CristianoUTEC/Flordelana/README.md

# Flordelana
Repositorio destinado a compartir el diseño de ruecas motorizadas para el hilado artesanal de lana.
