CristianoUTEC/Flordelana/Planos/dibujo.pdf

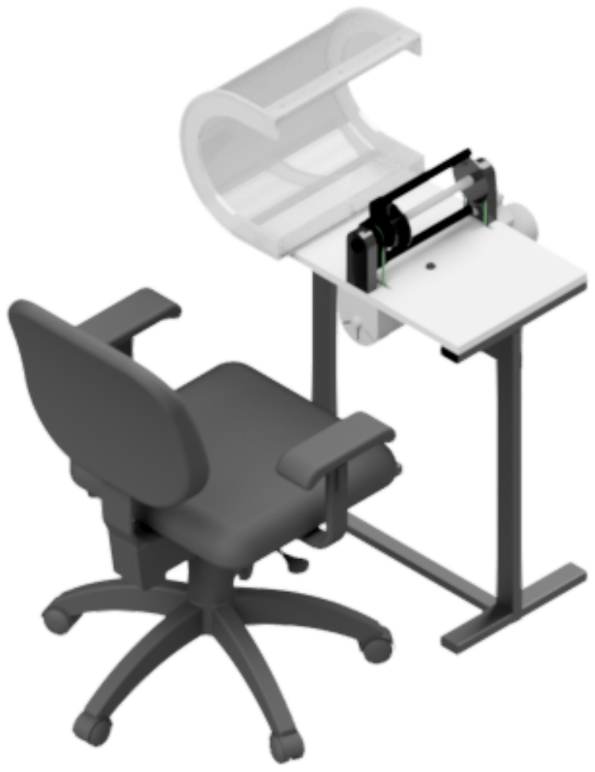
[picture p1: page 1]
