CristianoUTEC/Flordelana/CAD/Montaje.stp

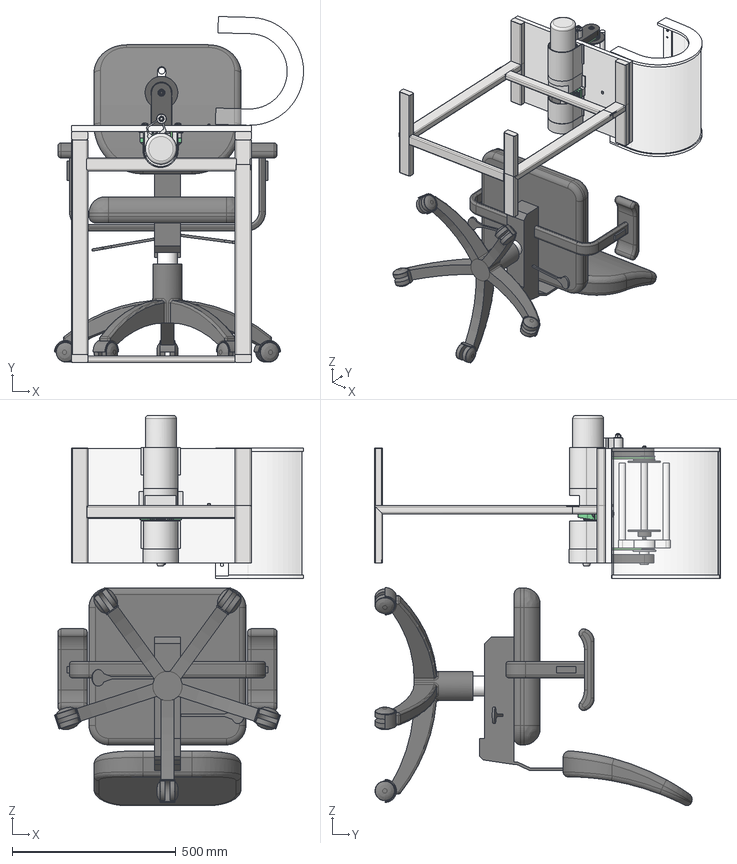
[picture p2: CAD file, 2021-09-22]
CAD/Montaje.stp
761.7 x 1057.9 x 1193.4 mm
soporte_riel
ANSI/AFBMA 16.1 - 25 x 47 x 14
soporte_riel_1
DIN 471 - 10x1 x 2
Centro
Reel1ACABARMEDIDAS
Reel1ACABARMEDIDAS_1
SKF_6000_PART1 x 2
SKF_6000_PART2 x 2
SKF_6000_PART3 x 14
SKF_6000_PART4 x 14
Sup.Acrilico x 4
Acrilico
Base.pin.Seg
Tapa Frontar y Posterior x 2
extructura_mesa
Skeleton 1572033469408
ISO 12633-2 - 50x25x2.5 - 350
ISO 12633-2 - 50x25x2.5 - 175
ISO 12633-2 - 50x25x2.5 - 175_1
ISO 12633-2 - 50x25x2.5 - 175_2
ISO 12633-2 - 50x25x2.5 - 175_3
ISO 12633-2 - 50x25x2.5 - 175_4
ISO 12633-2 - 50x25x2.5 - 175_5
ISO 12633-2 - 50x25x2.5 - 681
ISO 12633-2 - 50x25x2.5 - 606
ISO 12633-2 - 50x25x2.5 - 75
ISO 4019 - 40x20x2 - 550
ISO 4019 - 40x20x2 - 452,5
Placa Esquinas empalmadas (mm) 25 x 50 x 1 x 8
mesa_1
TapaEje_1
TapaEje_3 x 2
TapaEje_2
Cadeira_preta
ISO 4032 - M8 x 4
ISO 4014 - M8 x 55 x 4
ANSI/AFBMA 16.1 - 10 x 22 x 6
ISO 4014 - M10 x 70
ISO 7089 - 14
ISO 4032 - M10
PB-2P-MPBS
soporte planetario
brazos_planetarios1 x 2
brazos_planetarios1_1 x 2
vailla enroscada
UCP-204
Eje_Base
SoporteMancal
PoleaBrazos
motor2
PoleaBrazos_1
ISO 7045 - M10 x 60 - 4.8 - Z x 2
ISO 4035 - M10 x 2
Polea x 2
