CristianoUTEC/Flordelana/(list of files, cad)

Other CAD files:
CAD/TapaSeguridad/TapaSeguridad-1.dwg
CAD/TapaSeguridad/OldVersions/TapaSeguridad-1.0002.dwg
CAD/10 mm to 10mm flexible shaft coupler.ipt
CAD/608RS.ipt
CAD/ANSI_AFBMA 16.1 - 10 x 22 x 6.ipt
CAD/ANSI_AFBMA 16.1 - 25 x 37 x 7.ipt
CAD/Cadeira_preta.ipt
CAD/Conjunto transimisión.iam
CAD/DIN 471 - 10x1.ipt
CAD/DIN 471 - 22x1,2.ipt
CAD/Eje_Base.ipt
CAD/ISO 2491 - A 5 x 3 x 10.ipt
CAD/ISO 4161 - M10.ipt
CAD/KP08.iam
CAD/KP08.ipt
CAD/Mesa.iam
CAD/Mesa.ipt
CAD/Mesa/Frame/Frame 1572033469407.iam
CAD/Mesa/Frame/ISO 40x20x2 1572033628535.ipt
CAD/Mesa/Frame/ISO 40x20x2 1572033700429.ipt
CAD/Mesa/Frame/ISO 50x25x2.5 1572033477965.ipt
CAD/Mesa/Frame/ISO 50x25x2.5 1572033477966.ipt
CAD/Mesa/Frame/ISO 50x25x2.5 1572033477967.ipt
CAD/Mesa/Frame/ISO 50x25x2.5 1572033538820.ipt
CAD/Mesa/Frame/ISO 50x25x2.5 1572033538821.ipt
CAD/Mesa/Frame/ISO 50x25x2.5 1572033538822.ipt
CAD/Mesa/Frame/ISO 50x25x2.5 1572033538823.ipt
CAD/Mesa/Frame/ISO 50x25x2.5 1572033538824.ipt
CAD/Mesa/Frame/ISO 50x25x2.5 1572033538825.ipt
CAD/Mesa/Frame/ISO 50x25x2.5 1572033538826.ipt
CAD/Mesa/Frame/Plate Esquinas empalmadas (mm) 1572034518632.ipt
CAD/Mesa/Frame/Skeleton 1572033469408.ipt
CAD/Montaje Bobinador.iam
CAD/Montaje Bobinador.ipn
CAD/Montaje Reel.iam
CAD/Montaje.iam
CAD/Montaje.ipn
CAD/MontajeCon Cadeira.ipt
CAD/PK000.ipt
CAD/Polea.ipt
CAD/PoleaBrazos.ipt
CAD/PoleaMotor.ipt
CAD/Reel1.ipt
CAD/Reel2.ipt
CAD/SoporteMancal.ipt
CAD/Switch.ipt
CAD/TapaEje.iam
CAD/TapaEje1.ipt
CAD/TapaEje2.ipt
CAD/TapaEje3.ipt
CAD/TapaSeguridad/Acrilico.ipt
CAD/TapaSeguridad/Base.pin.Seg.ipt
CAD/TapaSeguridad/OldVersions/Acrilico.0013.ipt
CAD/TapaSeguridad/OldVersions/Base.pin.Seg.0004.ipt
CAD/TapaSeguridad/OldVersions/Sup.Acrilico.0009.ipt
CAD/TapaSeguridad/OldVersions/Tapa Frontar y Posterior.0002.ipt
CAD/TapaSeguridad/OldVersions/TapaSeguridad.0028.iam
CAD/TapaSeguridad/Sup.Acrilico.Segur.ipt
CAD/TapaSeguridad/Sup.Acrilico.ipt
CAD/TapaSeguridad/Tapa Frontar y Posterior.ipt
CAD/TapaSeguridad/TapaSeguridad.iam
CAD/UCP-204.ipt
CAD/Varilla_Enroscada.ipt
CAD/brazos_planetarios1.ipt
CAD/brazos_planetarios1v2.ipt
CAD/brazos_planetarios2.ipt
CAD/extructura_mesa.ipt
CAD/motor.ipt
CAD/soporte planetario.ipt
CAD/soporte_riel.ipt
CAD/soporte_riel2.ipt
CAD/soporte_rueca.ipt
