CristianoUTEC/Flordelana/Planos/Montaje.png

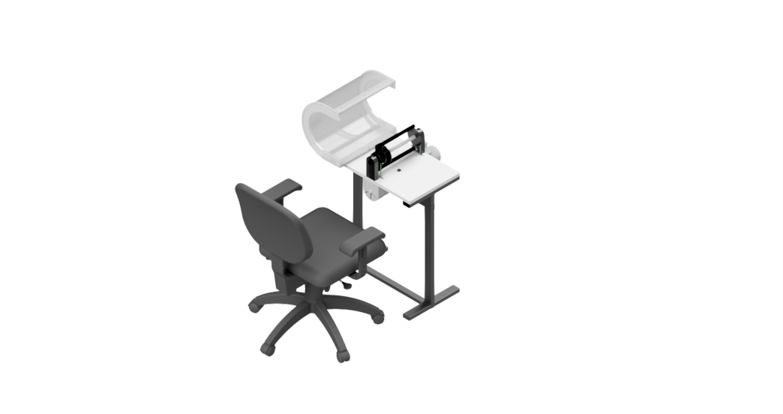
Planos/Montaje.png
