CristianoUTEC/Flordelana/Planos/Intructivo de Montaje.pdf

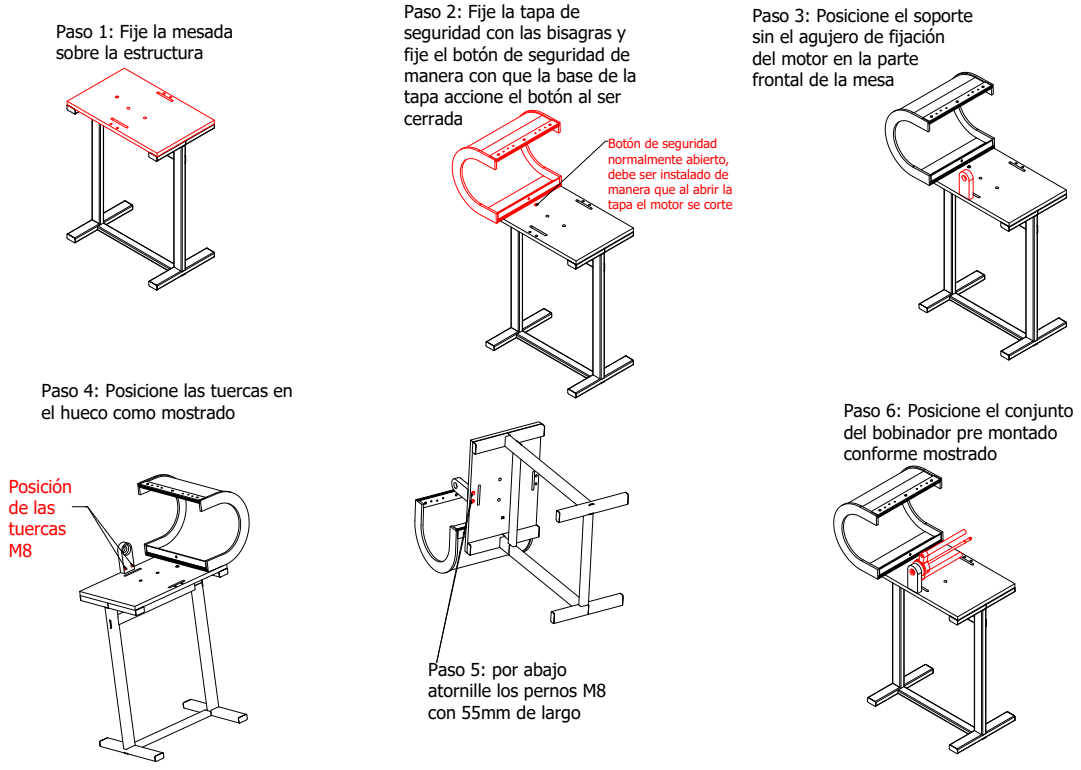
[picture p4: page 1]
de las

Paso 2: Fije la tapa de
seguridad con las bisagras y
fije el botyn de seguridad de
manera con que la base de la
tapa accione el botyn al ser
cerrada

Paso 3: Posicione el soporte
sin el agujero de fijaciyn
del motor en la parte
frontal de la mesa

Paso 1: Fije la mesada
sobre la estructura

Botyn de seguridad
normalmente abierto,
debe ser instalado de
manera que al abrir la
tapa el motor se corte

Paso 4: Posicione las tuercas en
el hueco como mostrado

Paso 6: Posicione el conjunto
del bobinador pre montado
conforme mostrado

Paso 5: por abajo
atornille los pernos M8
con 55mm de largo

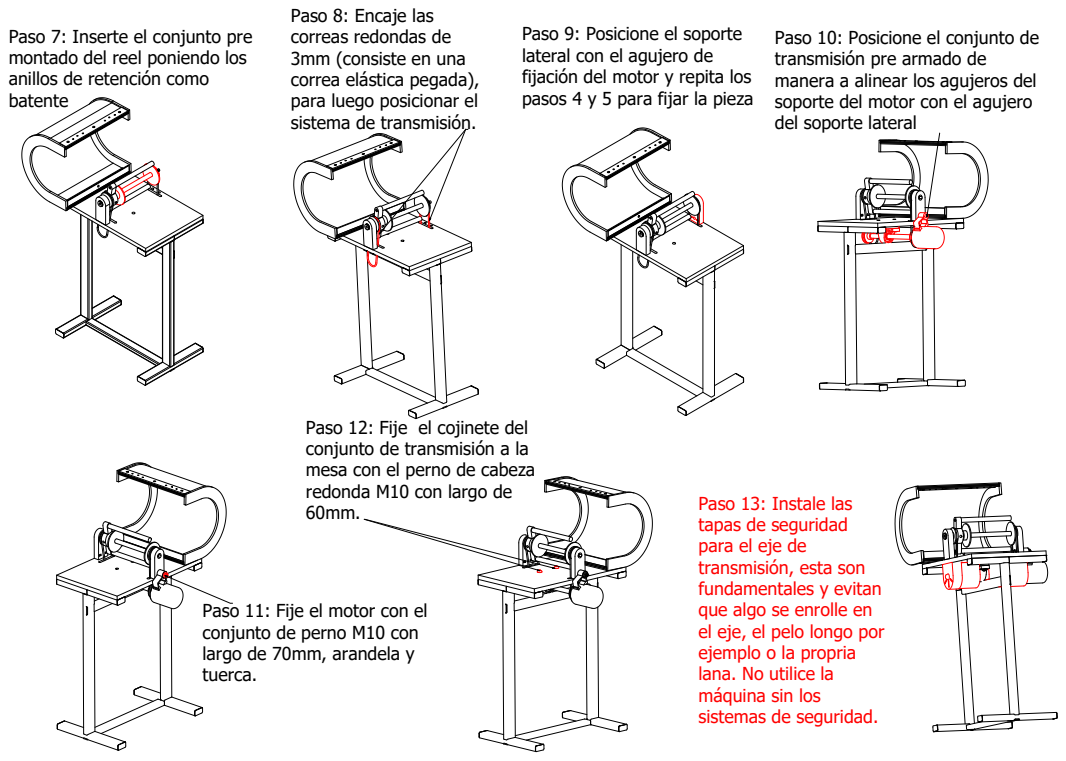
[picture p5: page 2]

Paso 8: Encaje las
correas redondas de
3mm (consiste en una
correa elistica pegada),
para luego posicionar el
sistema de transmisiyn.

Paso 9: Posicione el soporte
lateral con el agujero de
fijaciyn del motor y repita los
pasos 4 y 5 para fijar la pieza

Paso 7: Inserte el conjunto pre
montado del reel poniendo los
anillos de retenciyn como
batente

Paso 10: Posicione el conjunto de
transmisiyn pre armado de
manera a alinear los agujeros del
soporte del motor con el agujero
del soporte lateral

Paso 12: Fije el cojinete del
conjunto de transmisiyn a la
mesa con el perno de cabeza
redonda M10 con largo de

Paso 13: Instale las
tapas de seguridad
para el eje de
transmisiyn, esta son
fundamentales y evitan
que algo se enrolle en
el eje, el pelo longo por
ejemplo o la propria
lana. No utilice la
miquina sin los
sistemas de seguridad.

Paso 11: Fije el motor con el
conjunto de perno M10 con
largo de 70mm, arandela y
tuerca.
