CristianoUTEC/Flordelana/Planos/Mesa.pdf

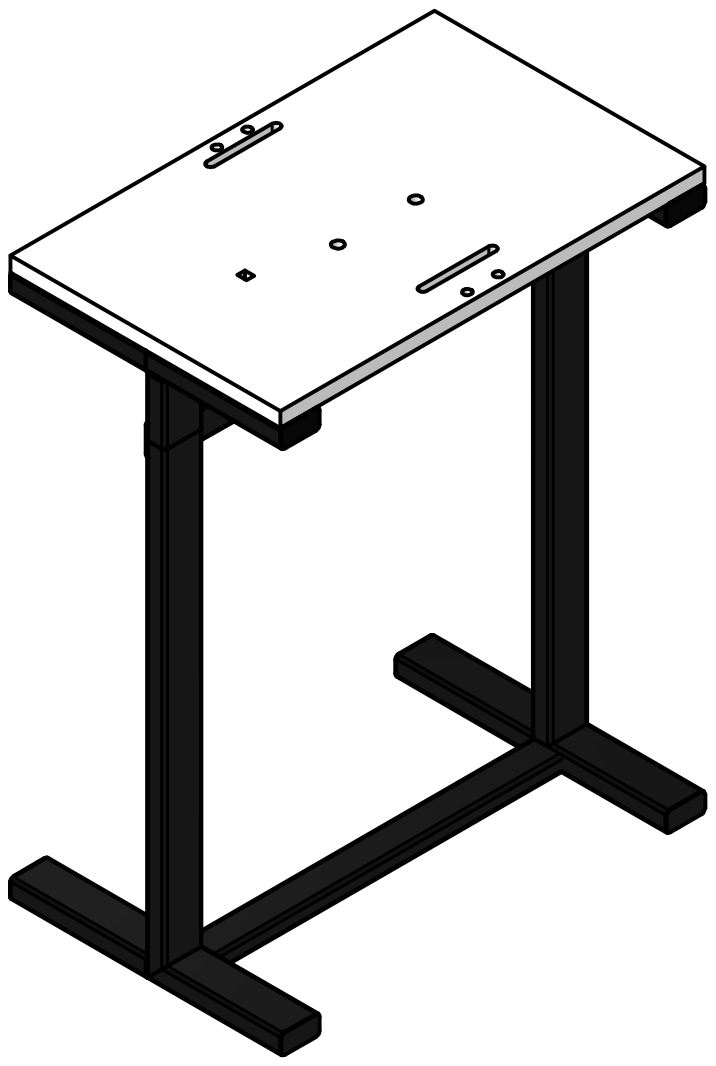
[picture p6: page 1]

Num. | Nombre: | Qtd. | Coment.

Nombre del archivo: Mesa.idw | Fecha: 17/8/2021

Escala:

Curso: Tecnylogo en Mec. Ind. | 1 Hoja:

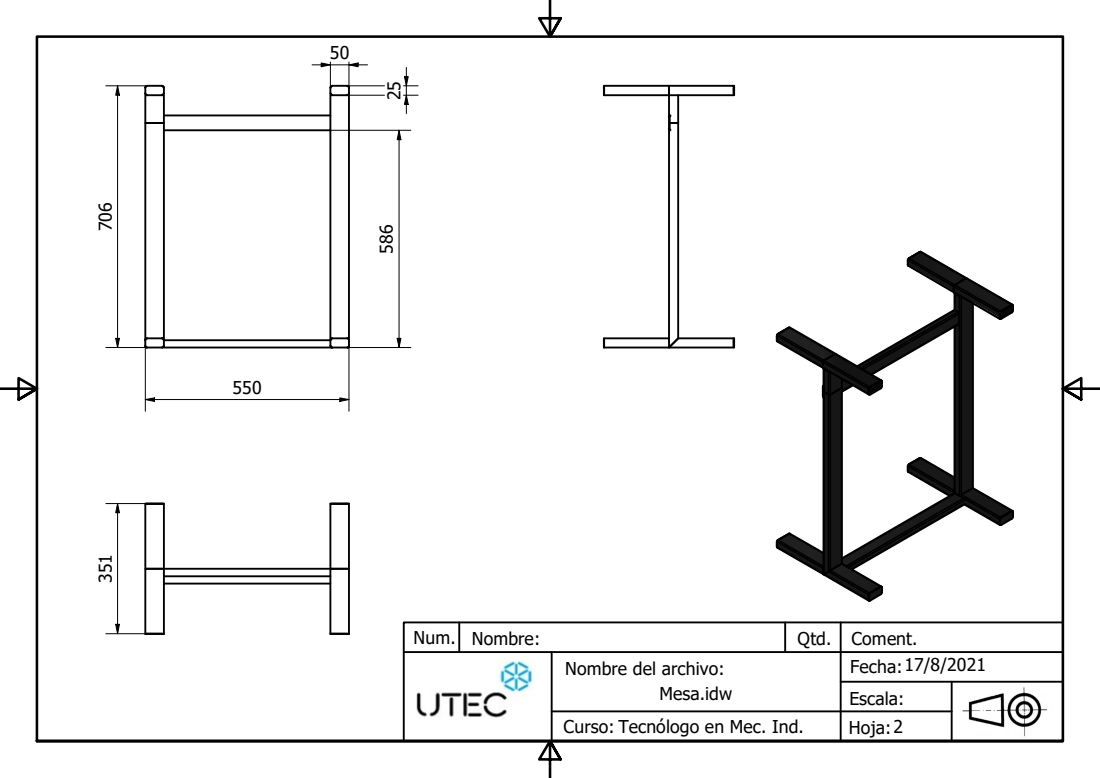
[picture p7: page 2]

Num. | Nombre: | Qtd. | Coment.

Nombre del archivo: Mesa.idw | Fecha: 17/8/2021

Escala:

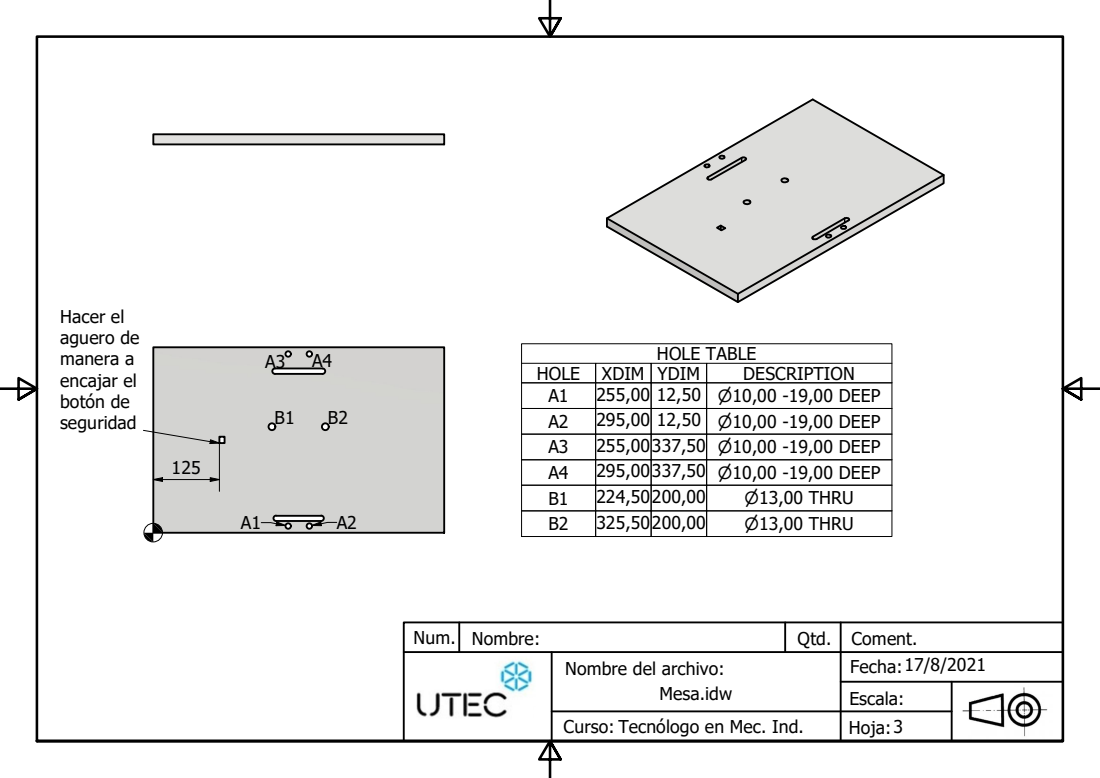
[picture p8: page 3]
HOLE TABLE; Hacer el aguero de manera a encajar el botyn de

HOLE | XDIM | YDIM | DESCRIPTION
A1 | 255,00 | 12,50 | 10,00 -19,00 DEEP
A2 | 295,00 | 12,50 | 10,00 -19,00 DEEP
A3 | 255,00337,50 | | 10,00 -19,00 DEEP
A4 | 295,00337,50 | | 10,00 -19,00 DEEP
B1 | 224,50200,00 | | 13,00 THRU
B2 | 325,50200,00 | | 13,00 THRU

Num. | Nombre: | Qtd. | Coment.

Nombre del archivo: Mesa.idw | Fecha: 17/8/2021

Escala:
