CristianoUTEC/Flordelana/Planos/Montaje Bobinador.pdf

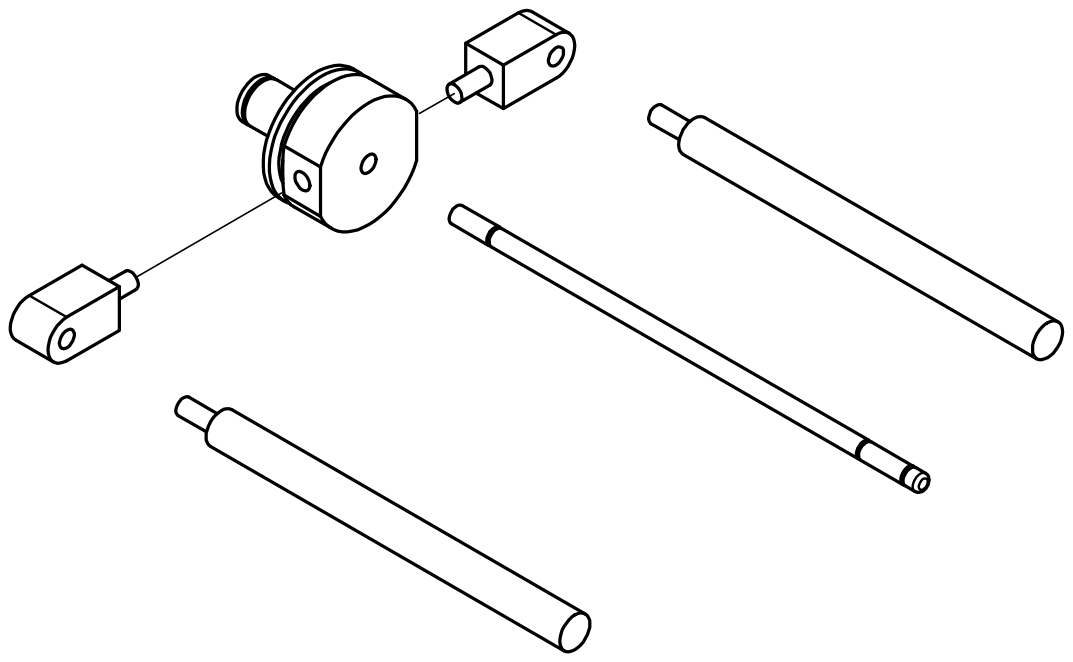
[picture p9: page 1]

Num. | Nombre: | Qtd. | Coment.

Nombre del archivo: Montaje Bobinador.idw | Fecha: 17/8/2021

Escala:

Curso: Tecnylogo en Mec. Ind. | 1 Hoja:

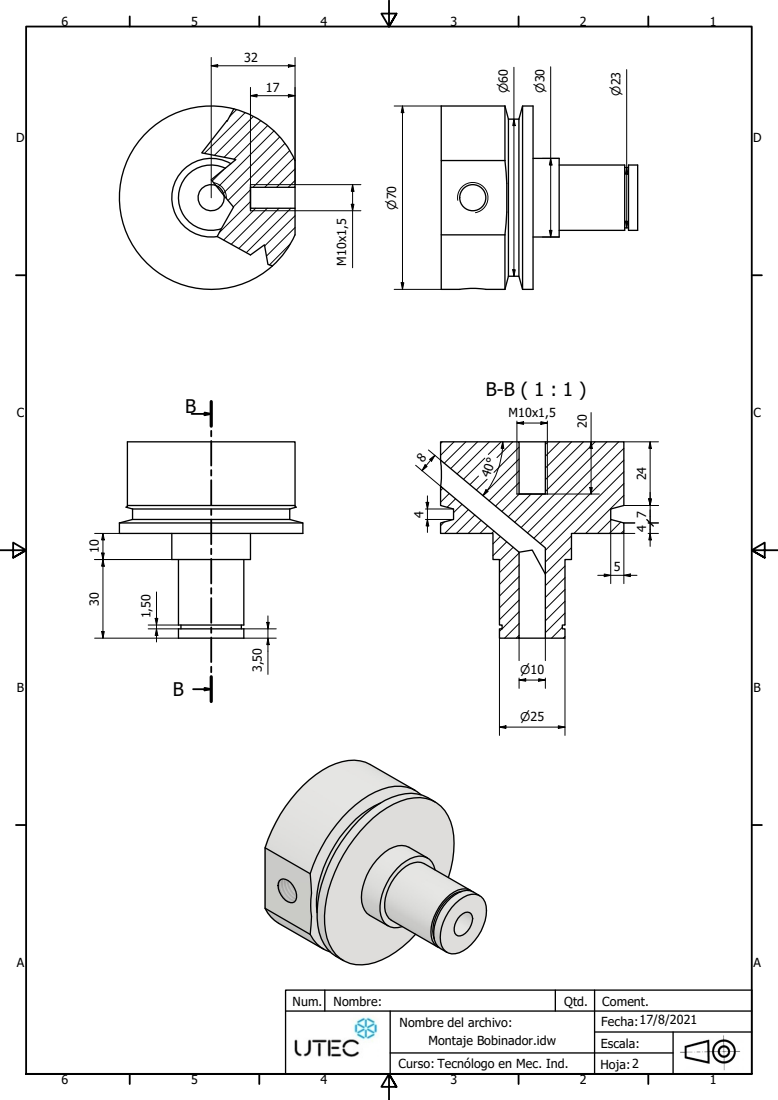
[picture p10: page 2]

Num. | Nombre: | Qtd. | Coment.

Nombre del archivo: Montaje Bobinador.idw | 17/8/2021 Fecha:

Escala:

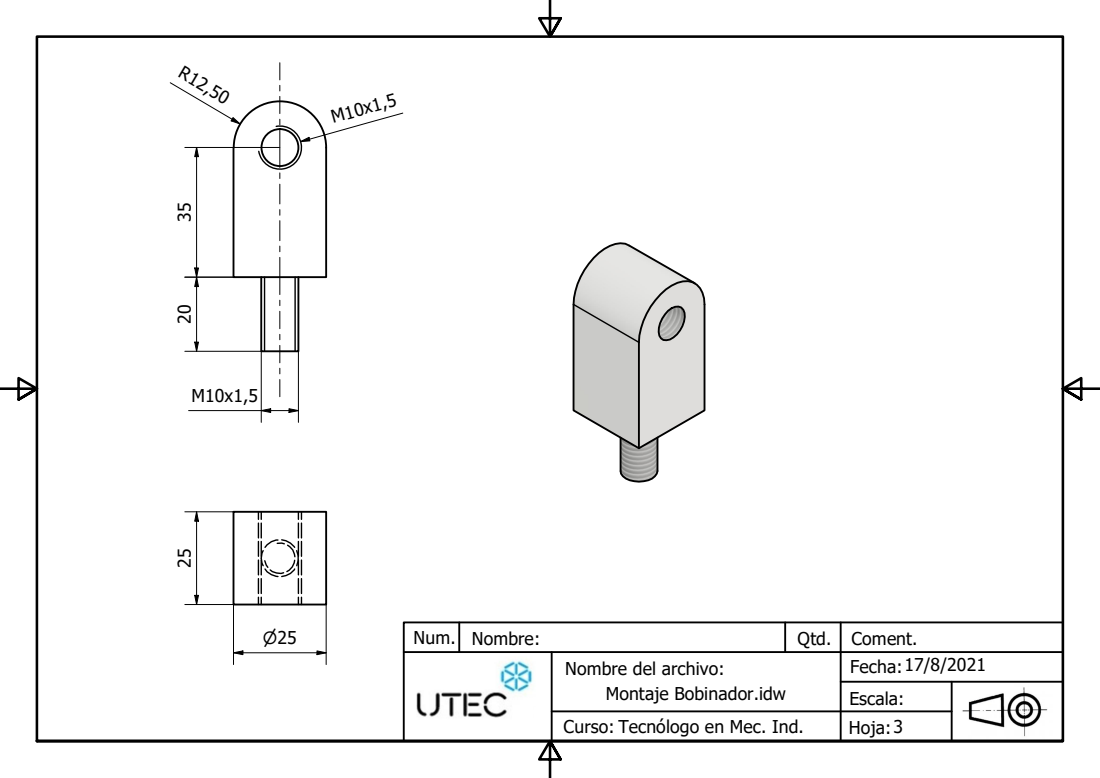
[picture p11: page 3]

Num. | Nombre: | Qtd. | Coment.

Nombre del archivo: Montaje Bobinador.idw | Fecha: 17/8/2021

Escala:

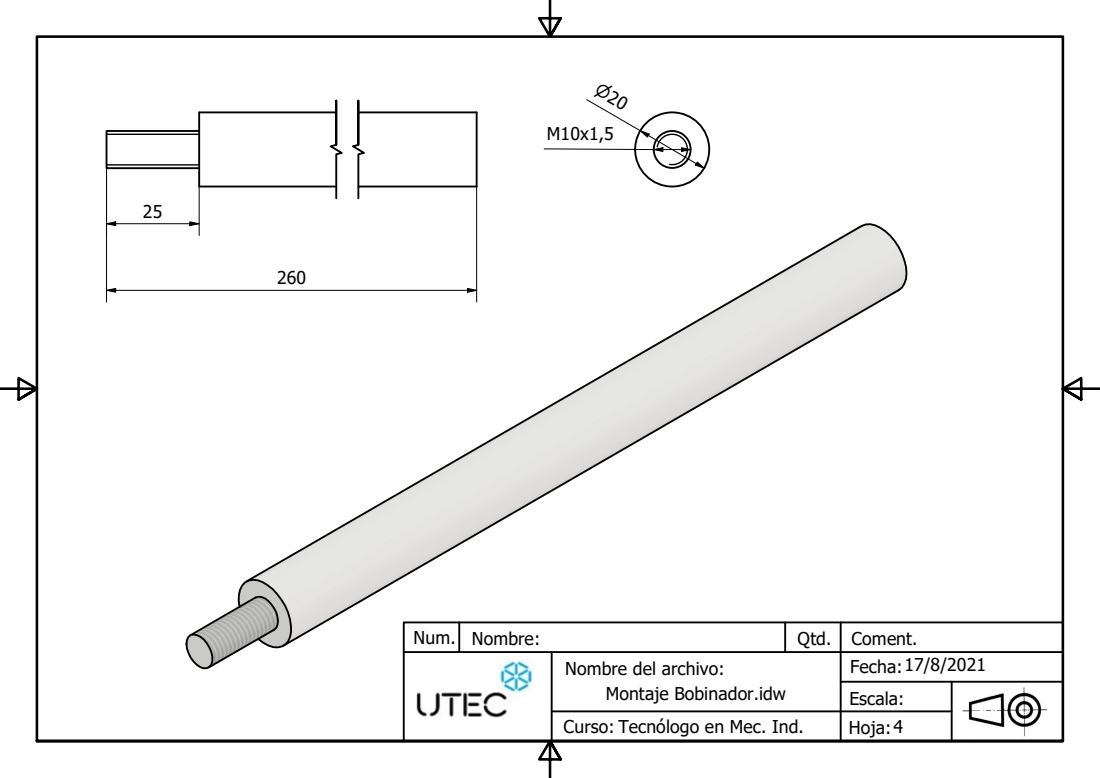
[picture p12: page 4]

Num. | Nombre: | Qtd. | Coment.

Nombre del archivo: Montaje Bobinador.idw | Fecha: 17/8/2021

Escala:

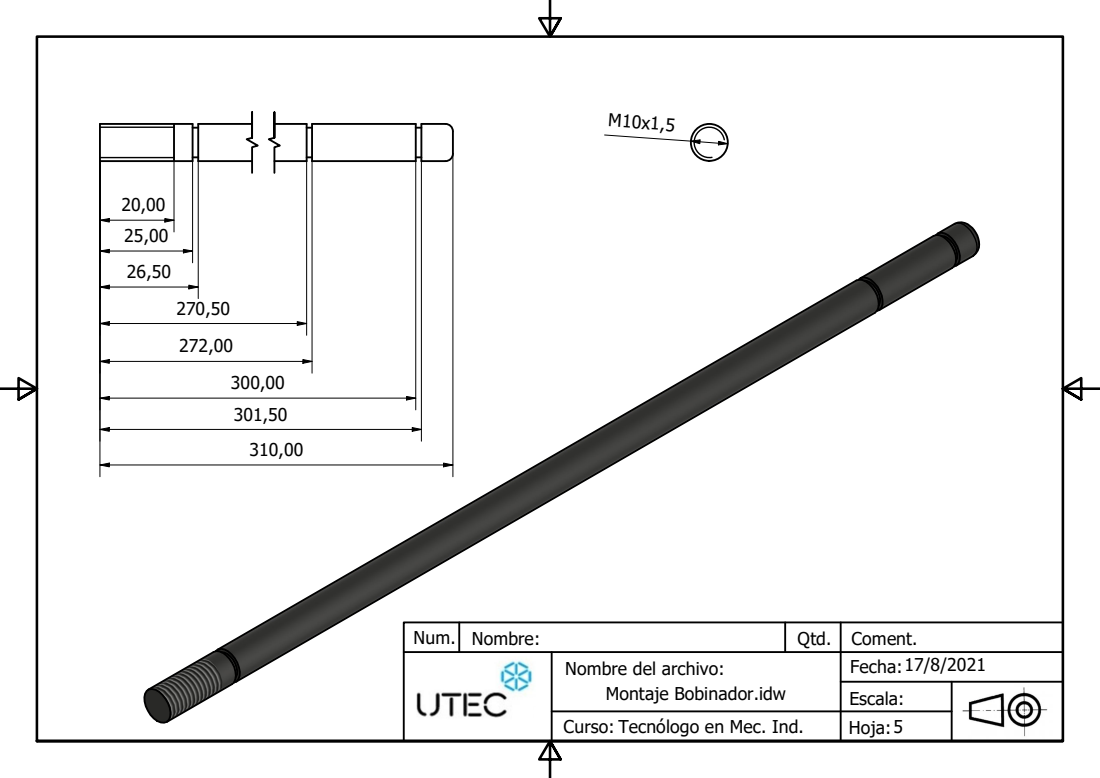
[picture p13: page 5]

Num. | Nombre: | Qtd. | Coment.

Nombre del archivo: Montaje Bobinador.idw | Fecha: 17/8/2021

Escala:
