CristianoUTEC/Flordelana/Planos/Montaje General.pdf

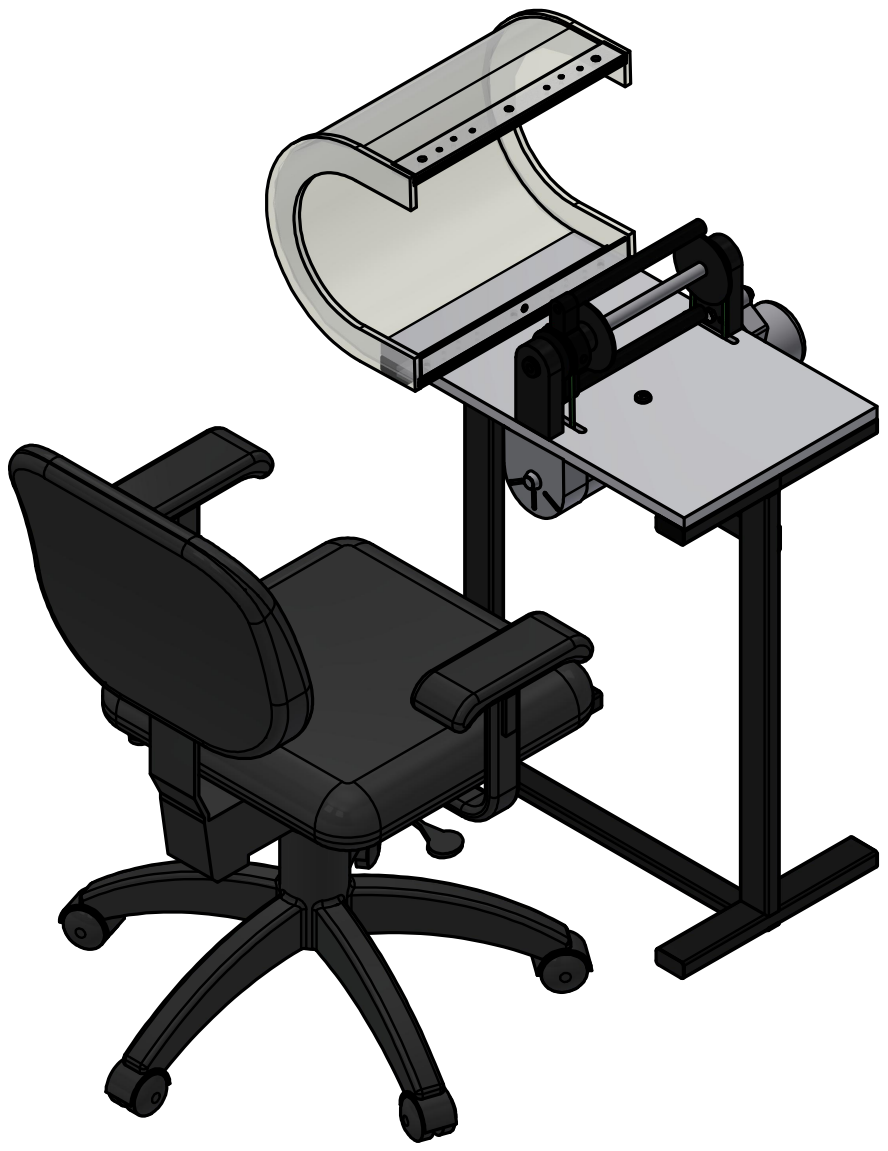
[picture p14: page 1]

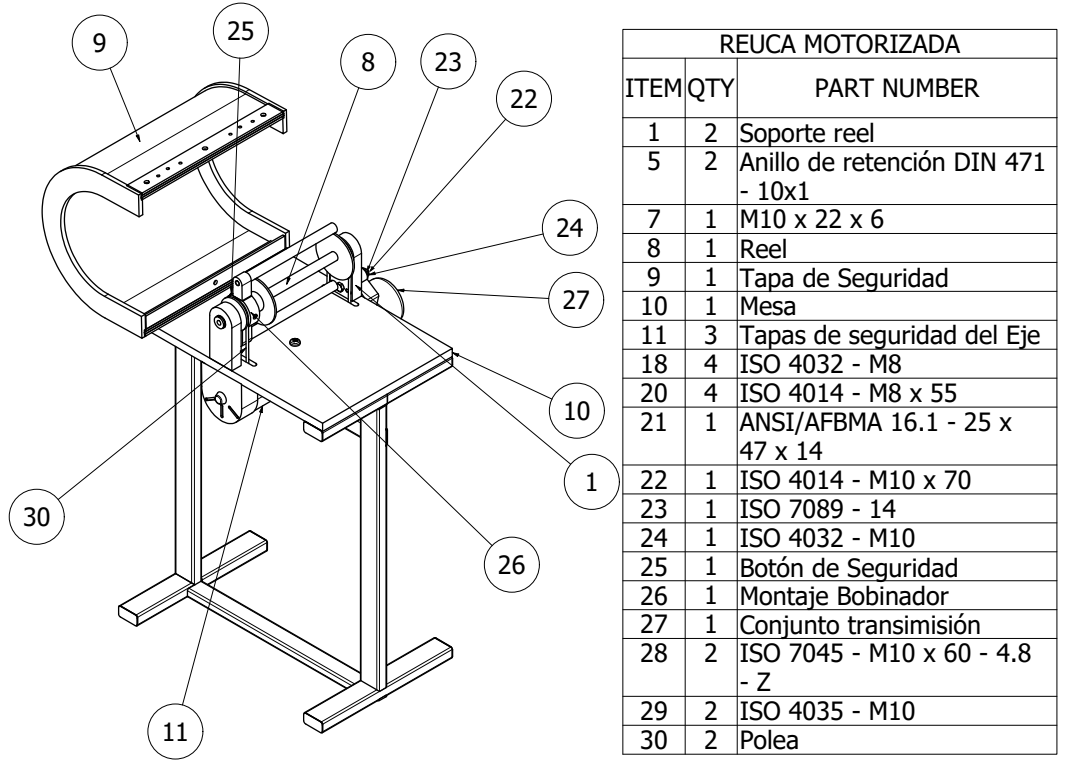
[picture p15: page 2]

I T E M | Q TY | P A RT N U M B E R
1 | 2 | S o p o r t e r e el Anillo de ret
5 | 2 | y e n c i n D I N 4 7 1 -1 0 x 1

7 | 1 | M 1 0 x 2 2 x 6
8 | 1 1 | R Tapa e el 9

1 0 | 1 | M e s a
1 1 | 3 | T a p a s d e s e g u r i d a d d el Ej e
1 8 | 4 | I S O 4 0 3 2 -M 8
2 0 | 4 | I S O 4 0 1 4 -M 8 x 5 5
2 1 | 1 | A N S I / A F B M A 1 6 . 1 -2 5 x 4 7 x 1 4

2 2 | 1 | I S O 4 0 1 4 -M 1 0 x 7 0
2 3 | 1 | I S O 7 0 8 9 -1 4
2 4 | 1 | I S O 4 0 3 2 -M 1 0
2 5 | 1 | y B o t n d e S e g u r i d a d
2 6 | 1 | M o n t a j e B o b i n a d o r
2 7 | 1 | y C o n j u n t o t r a n s i m i s i n
2 8 | 2 | I S O 7 0 4 5 -M 1 0 x 6 0 -4 . 8 -Z

2 9 | 2 | I S O 4 0 3 5 -M 1 0
3 0 | 2 | P ole a

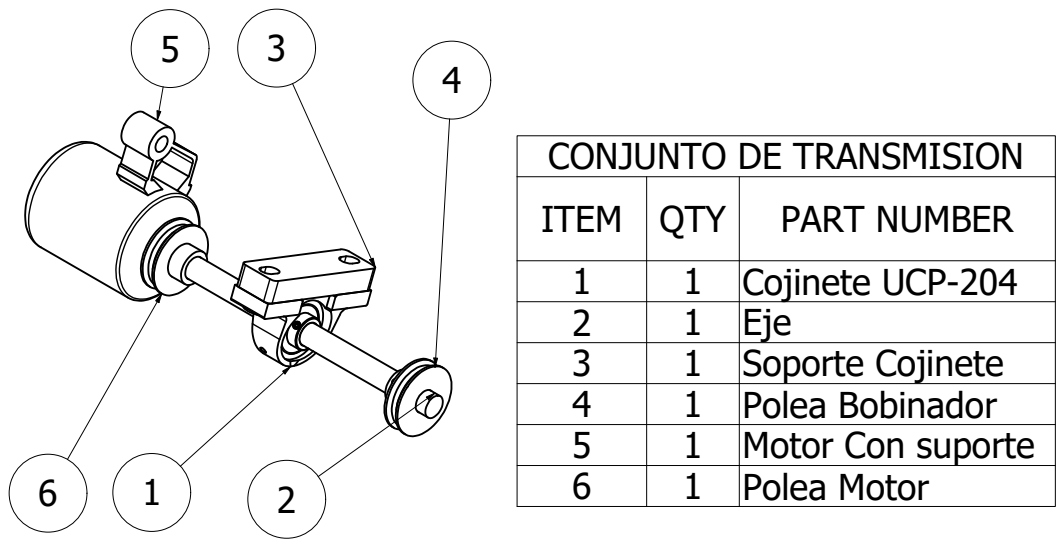
[picture p16: page 3]

I T E M | Q TY | P A RT N U M B E R
1 | 1 | C oj i n e t e U C P -2 0 4
2 | 1 | Ej e
3 | 1 | S o p o r t e C oj i n e t e
4 | 1 | P ole a B o b i n a d o r
5 | 1 | M o t o r C o n s u p o r t e
6 | 1 | P ole a M o t o r

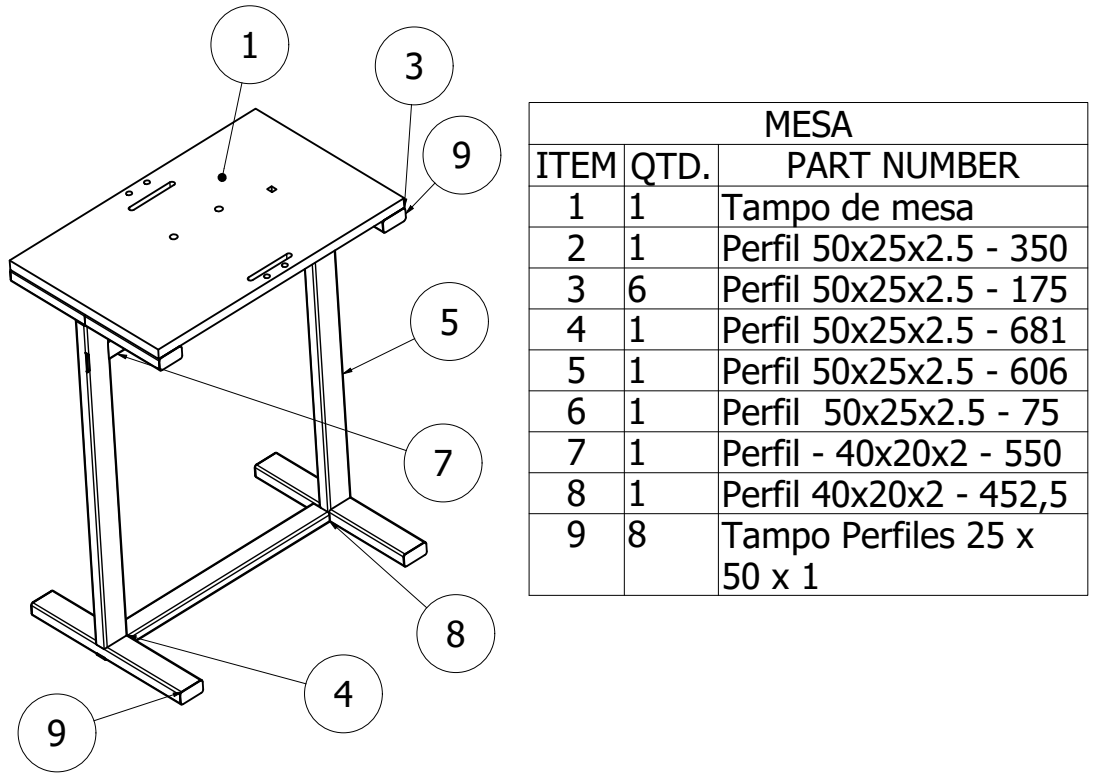
[picture p17: page 4]

I T E M | Q T D . | P A RT N U M B E R
1 | 1 | T a m p o d e m e s a
2 | 1 | P e r f il 5 0 x 2 5 x 2 . 5 -3 5 0
3 | 6 | P e r f il 5 0 x 2 5 x 2 . 5 -1 7 5
4 | 1 | P e r f il 5 0 x 2 5 x 2 . 5 -6 8 1
5 | 1 | P e r f il 5 0 x 2 5 x 2 . 5 -6 0 6
6 | 1 | P e r f il 5 0 x 2 5 x 2 . 5 -7 5
7 | 1 | P e r f il -4 0 x 2 0 x 2 -5 5 0
8 | 1 | P e r f il 4 0 x 2 0 x 2 -4 5 2 , 5
9 | 8 | T a m p o P e r f ile s 2 5 x 5 0 x 1

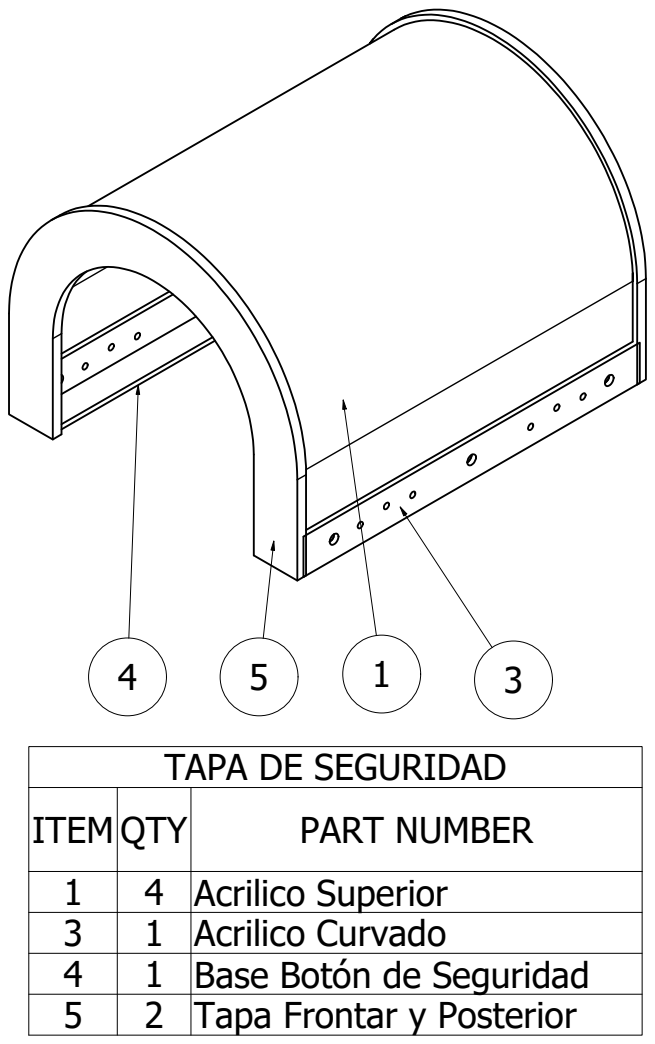
[picture p18: page 5]

TAPA DE SEGURIDAD

ITEM QTY | | PART NUMBER
1 | 4 | Acrilico Superior
3 | 1 | Acrilico Curvado
4 | 1 | Base Botyn de Seguridad
5 | 2 | Tapa Frontar y Posterior

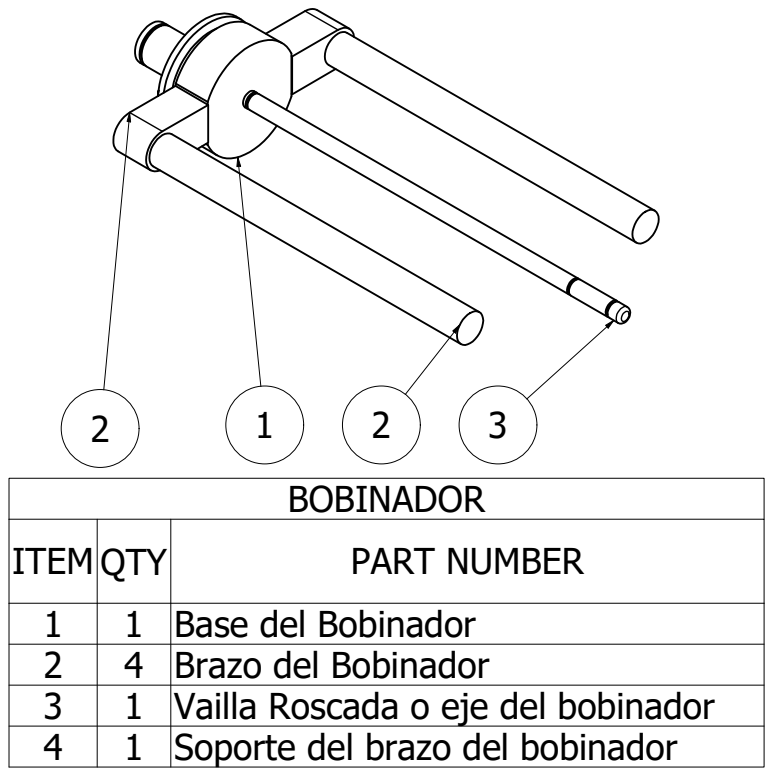
[picture p19: page 6]

ITEM QTY | | PART NUMBER
1 | 1 | Base del Bobinador
2 | 4 | Brazo del Bobinador
3 | 1 | Vailla Roscada o eje del bobinador
4 | 1 | Soporte del brazo del bobinador

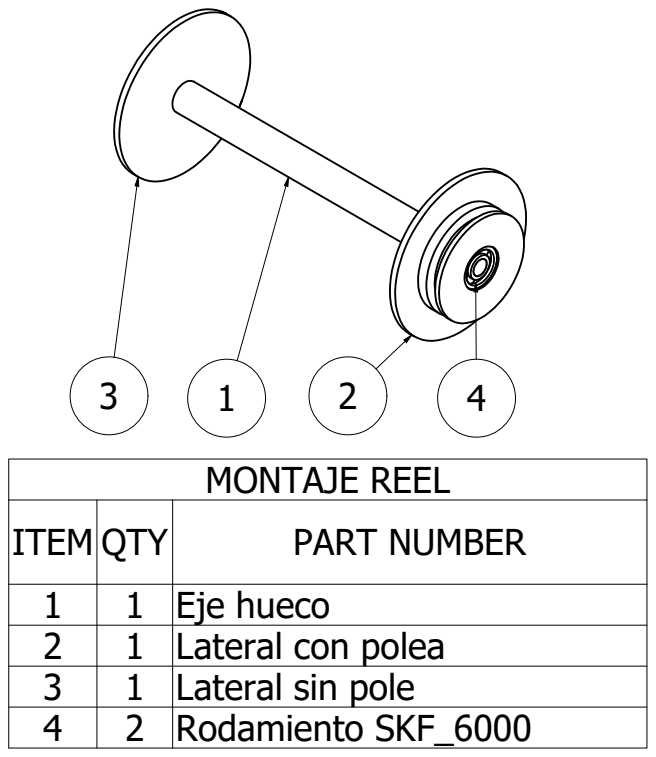
[picture p20: page 7]
MONTAJE REEL

ITEM QTY | | PART NUMBER
1 | 1 | Eje hueco
2 | 1 | Lateral con polea
3 | 1 | Lateral sin pole
4 | 2 | Rodamiento SKF_6000
