CristianoUTEC/Flordelana/Planos/Montaje Reel.pdf

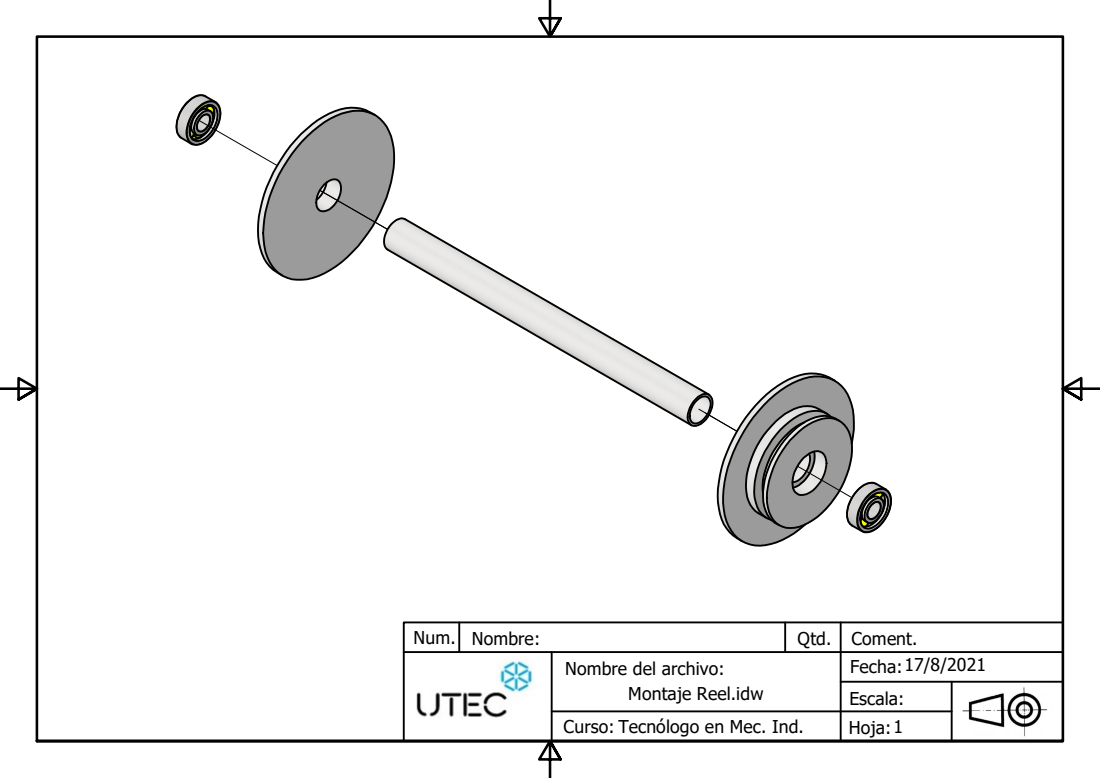
[picture p21: page 1]

Num. | Nombre: | Qtd. | Coment.

Nombre del archivo: Montaje Reel.idw | Fecha: 17/8/2021

Escala:

Curso: Tecnylogo en Mec. Ind. | 1 Hoja:

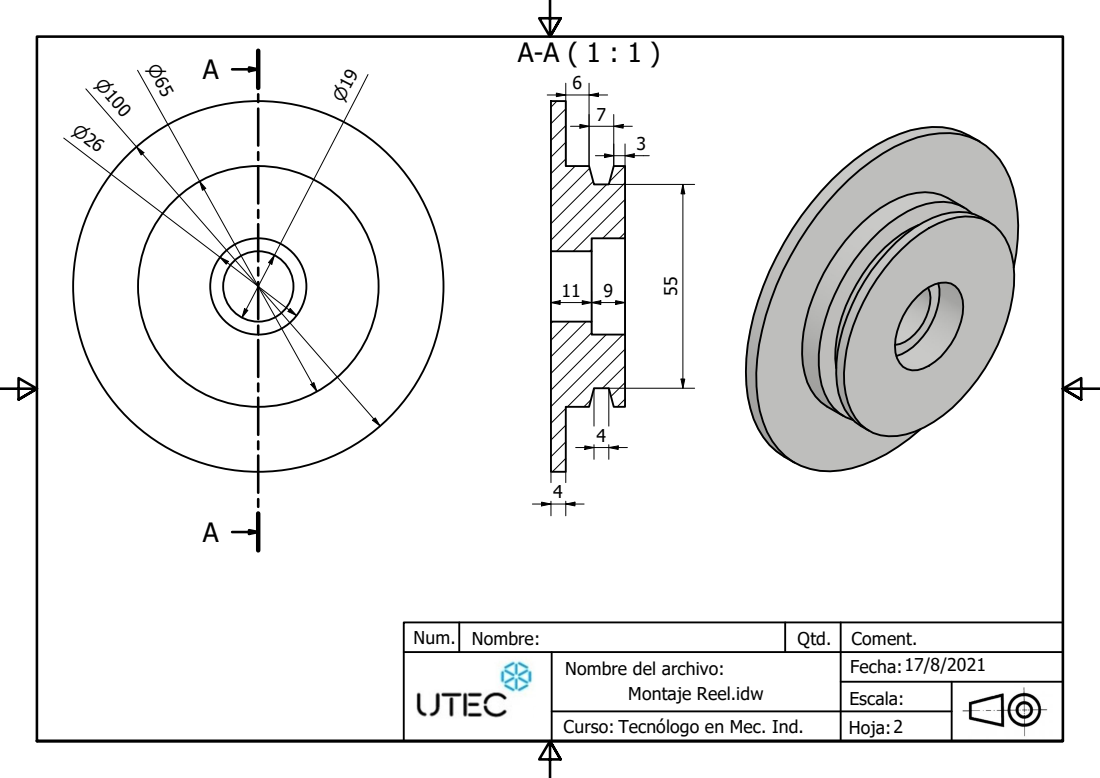
[picture p22: page 2]

Num. | Nombre: | Qtd. | Coment.

Nombre del archivo: Montaje Reel.idw | Fecha: 17/8/2021

Escala:

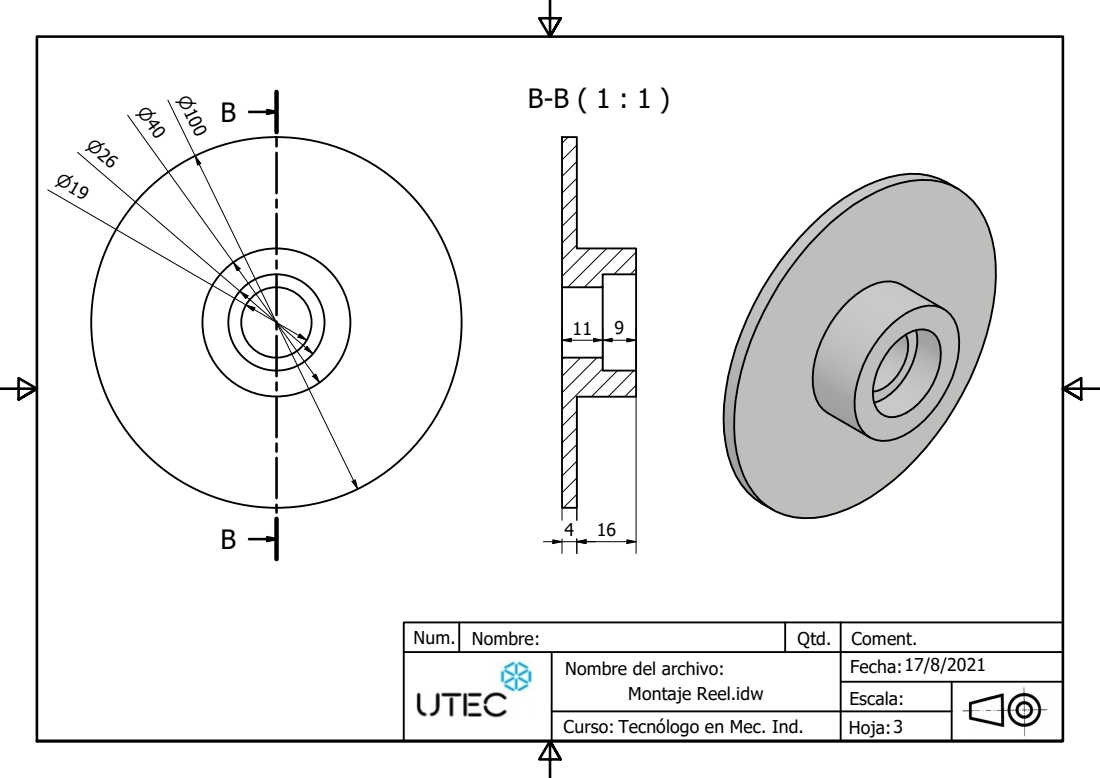
[picture p23: page 3]

Num. | Nombre: | Qtd. | Coment.

Nombre del archivo: Montaje Reel.idw | Fecha: 17/8/2021

Escala:

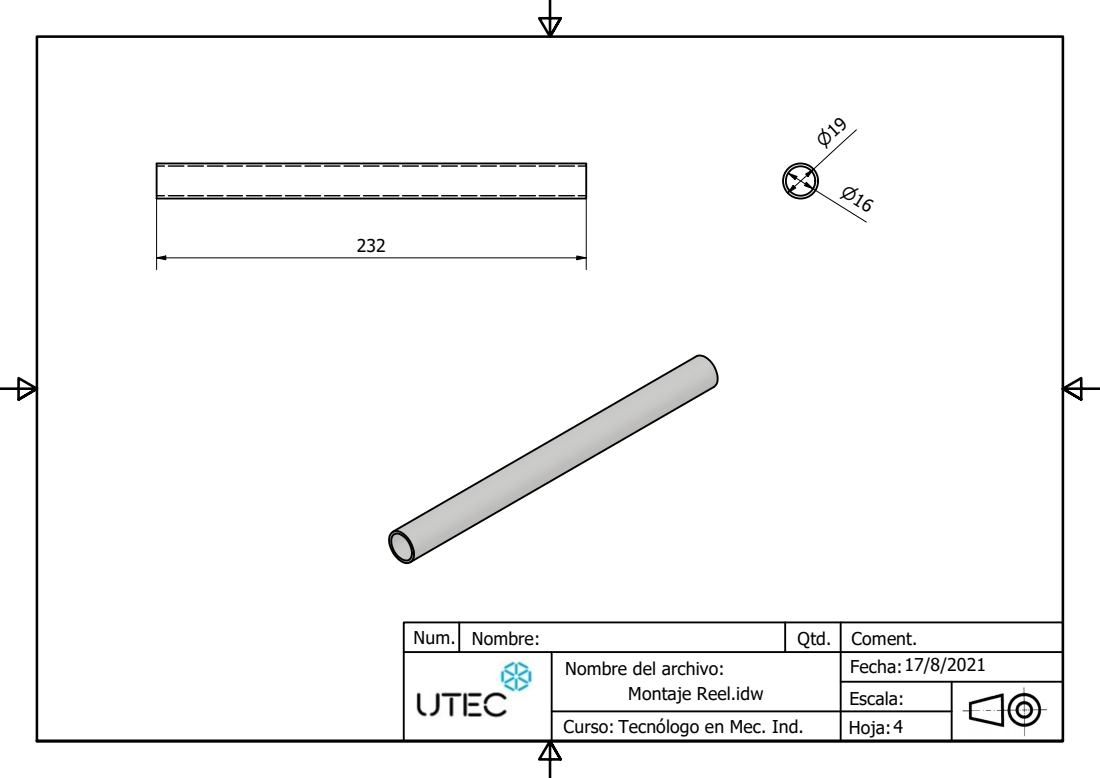
[picture p24: page 4]

Num. | Nombre: | Qtd. | Coment.

Nombre del archivo: Montaje Reel.idw | Fecha: 17/8/2021

Escala:
