CristianoUTEC/Flordelana/Planos/Conjunto transimisión.pdf

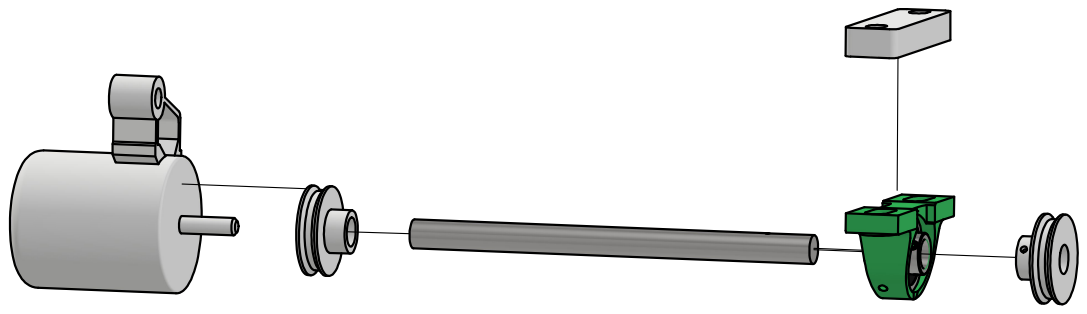
[picture p25: page 1]

Num. | Nombre: | Qtd. | Coment.

Nombre del archivo: Conjunto transimisiyn.idw | Fecha: 17/8/2021

Escala:

Curso: Tecnylogo en Mec. Ind. | 1 Hoja:

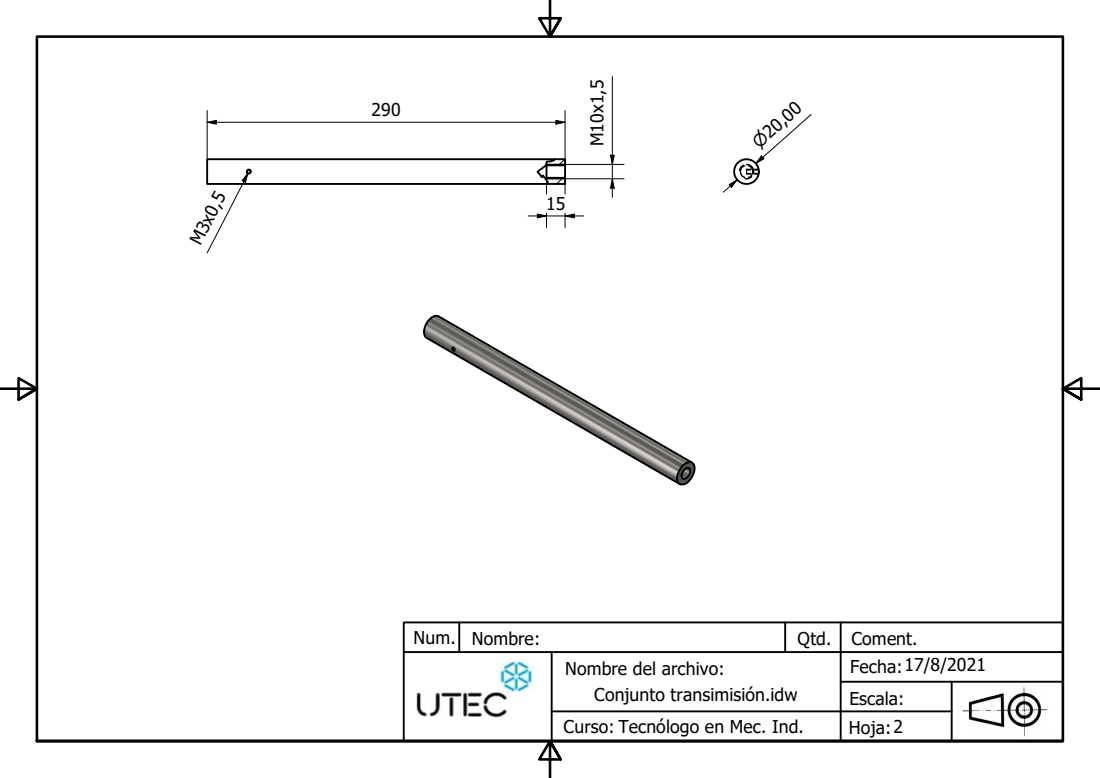
[picture p26: page 2]

Num. | Nombre: | Qtd. | Coment.

Nombre del archivo: Conjunto transimisiyn.idw | Fecha: 17/8/2021

Escala:

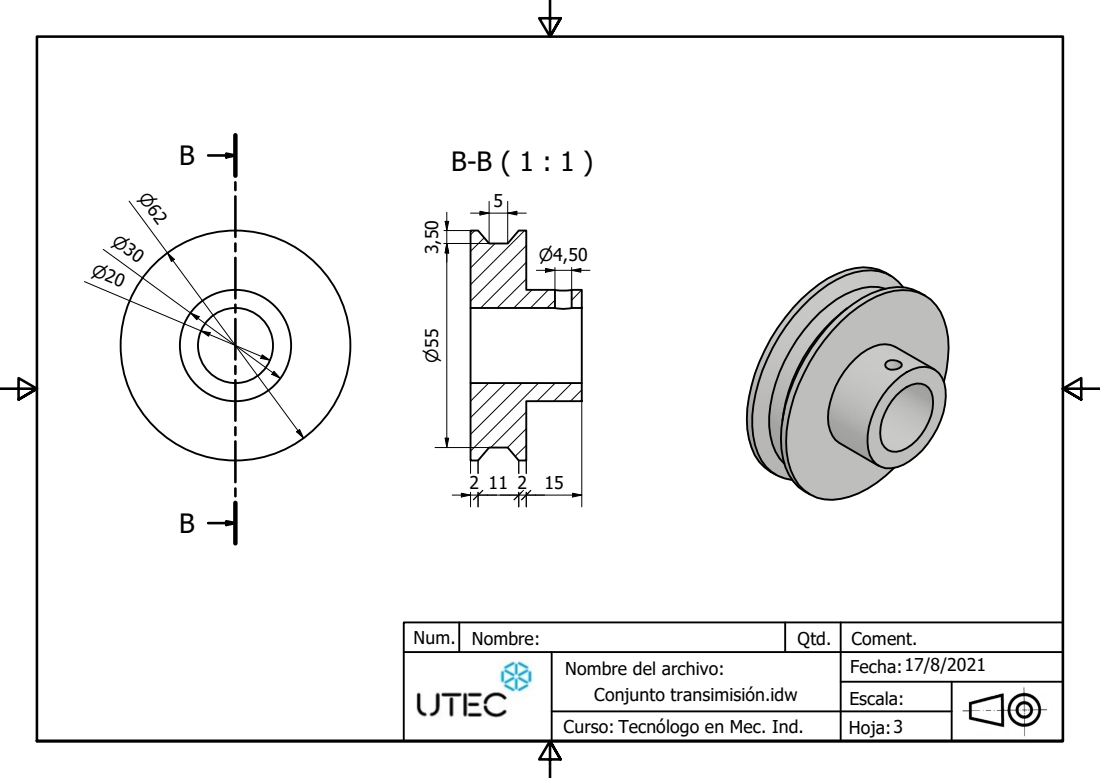
[picture p27: page 3]

Num. | Nombre: | Qtd. | Coment.

Nombre del archivo: Conjunto transimisiyn.idw | Fecha: 17/8/2021

Escala:

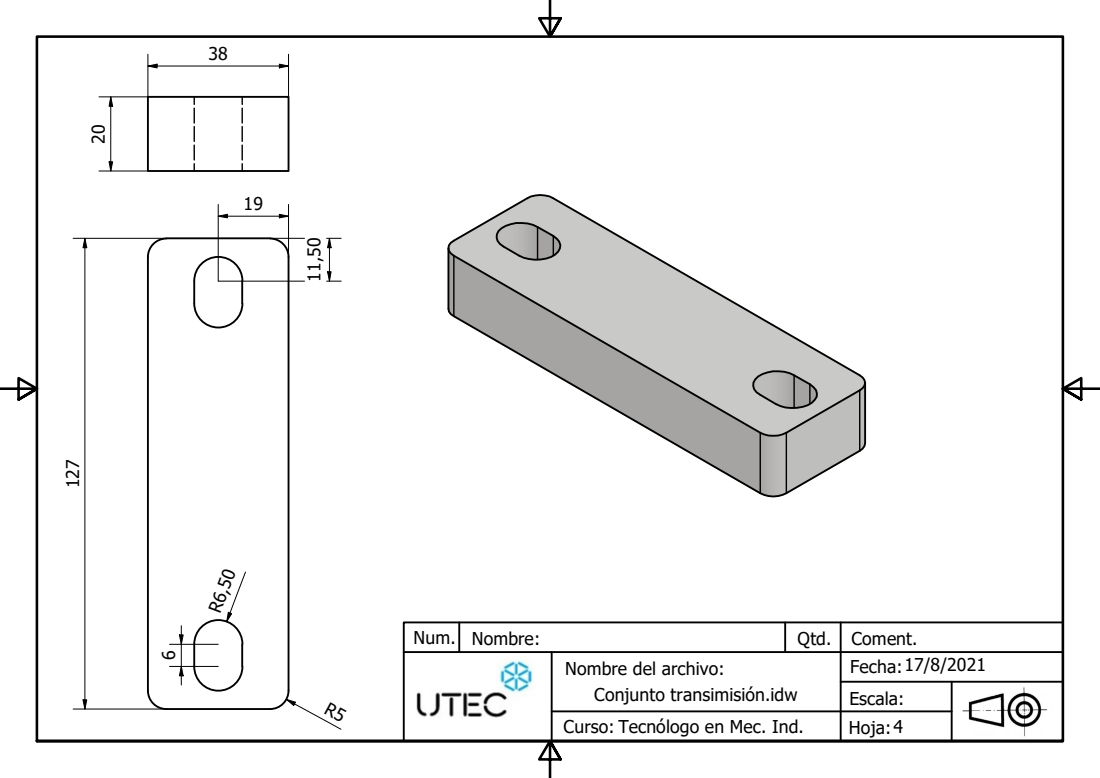
[picture p28: page 4]

Num. | Nombre: | Qtd. | Coment.

Nombre del archivo: Conjunto transimisiyn.idw | Fecha: 17/8/2021

Escala:
